foreber-v2/stm32-sinker-edm/docs/future-improvements.md

# G. Future Improvements

[⬅️ Back to Main](..)

---

## Coming Soon!
---

[⬅️ Back to Main](..)
