foreber-v2/stm32-sinker-edm/docs/engineering-decisions.md

# F. Engineering Decisions & Trade-offs 

[⬅️ Back to Main](..)

---

## Coming Soon!
---

[⬅️ Back to Main](..)
