foreber-v2/stm32-sinker-edm/docs/photos of electrode/IMG_20261029_143206.jpg

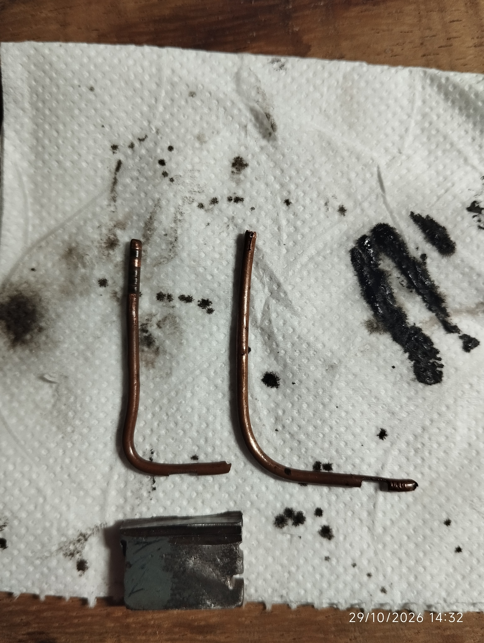
docs/photos of electrode/IMG_20261029_143206.jpg
