foreber-v2/stm32-sinker-edm/docs/photos of hardware/detail_rail_arm.jpg

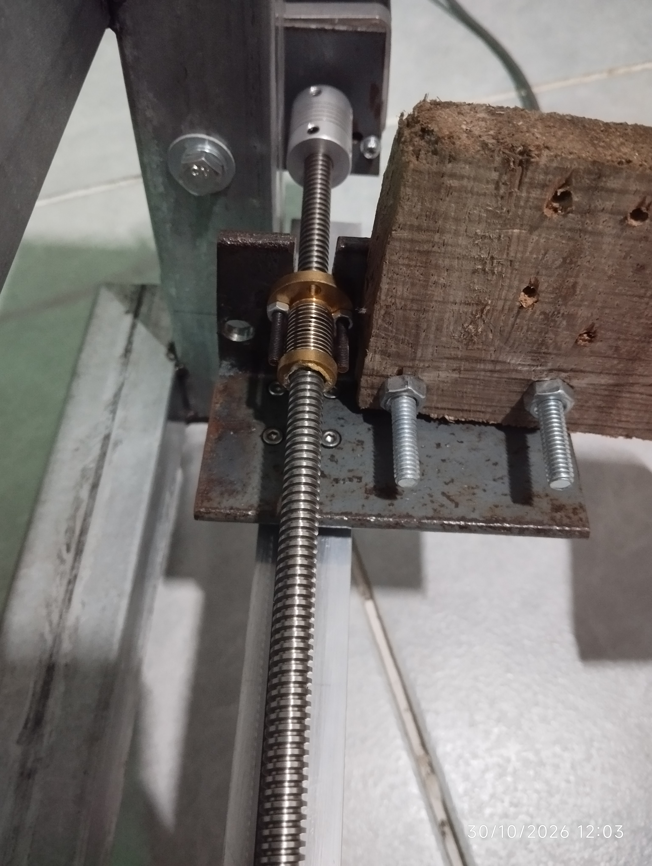
docs/photos of hardware/detail_rail_arm.jpg
