foreber-v2/stm32-sinker-edm/docs/photos of hardware/header_electrode.jpg

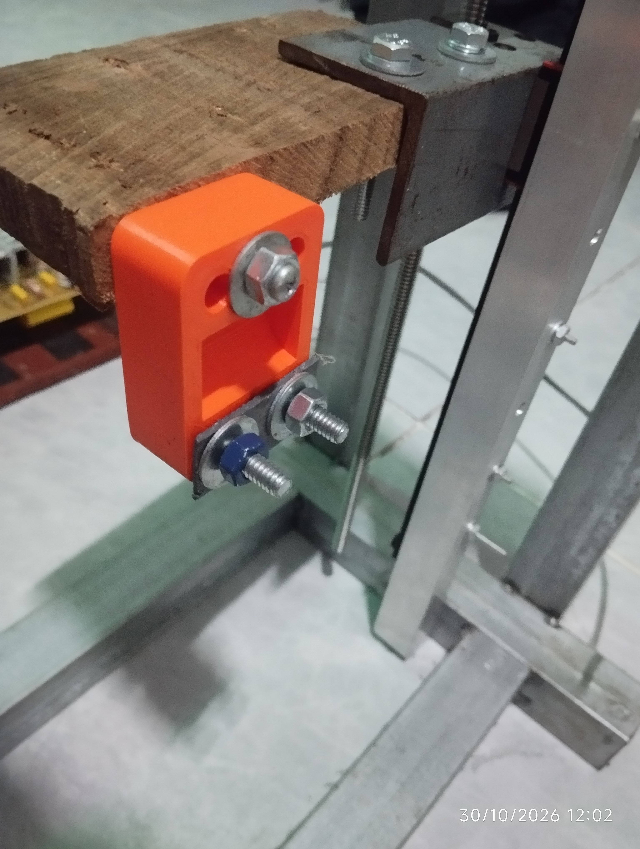
docs/photos of hardware/header_electrode.jpg
