foreber-v2/stm32-sinker-edm/docs/photos of hardware/IMG_20261030_114625.jpg

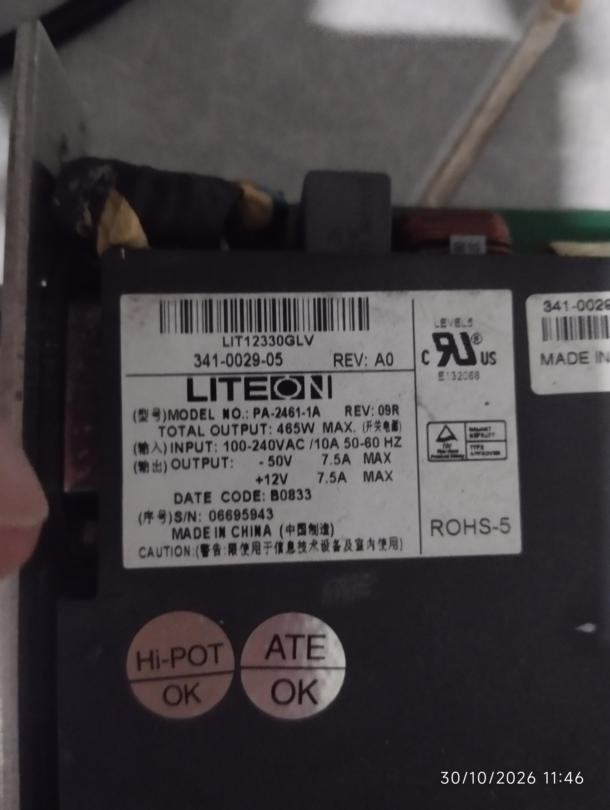
docs/photos of hardware/IMG_20261030_114625.jpg
