foreber-v2/stm32-sinker-edm/docs/photos of hardware/spark_gen.jpg

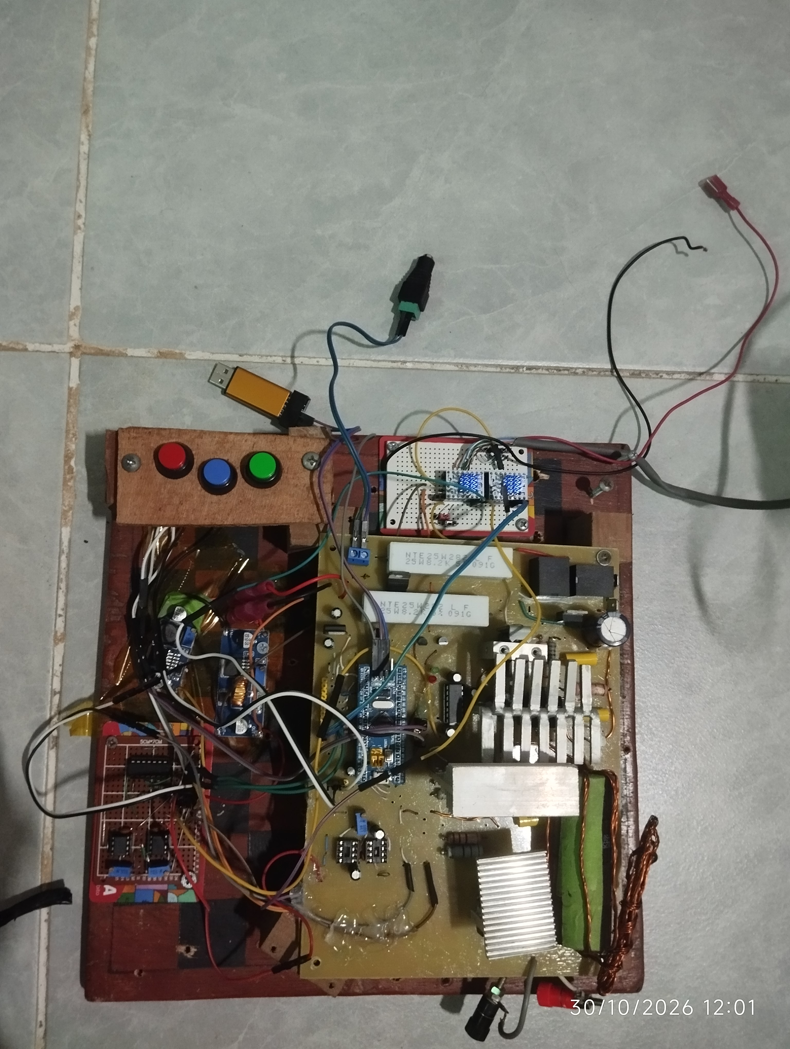
docs/photos of hardware/spark_gen.jpg
