foreber-v2/stm32-sinker-edm/docs/photos_of_electrode/electrodes_view_with_piece.jpg

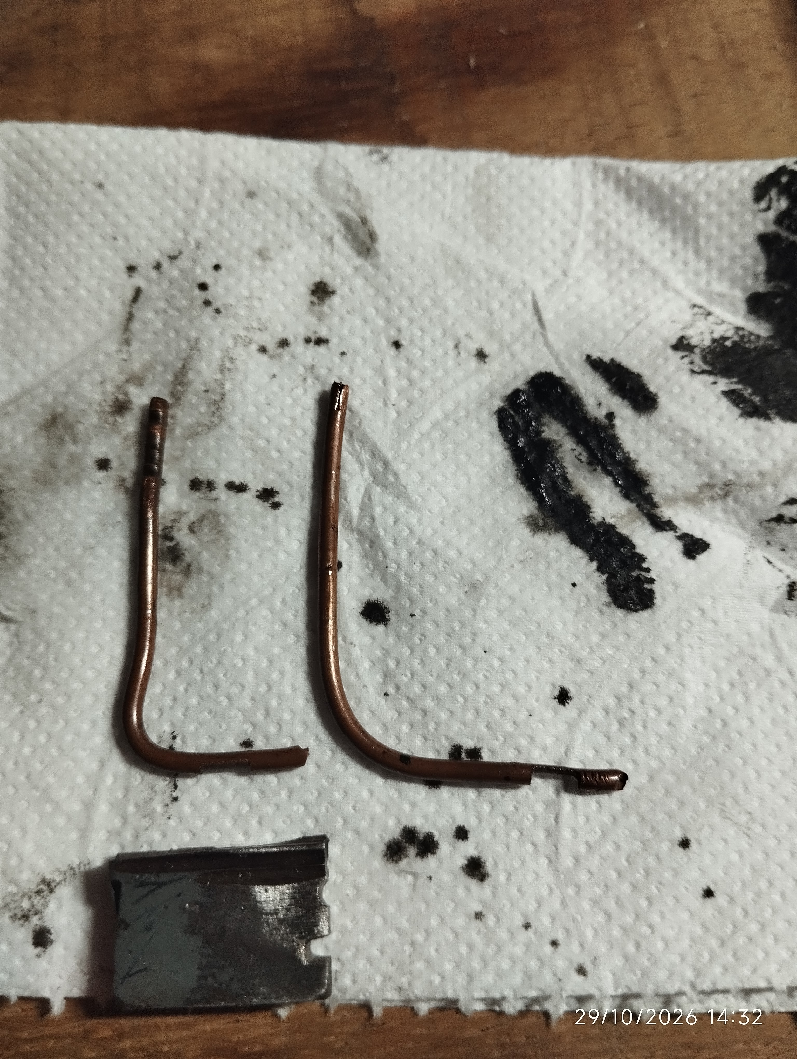
docs/photos_of_electrode/electrodes_view_with_piece.jpg
