foreber-v2/stm32-sinker-edm/images/photos_of_hardware/stepper_driver.jpg

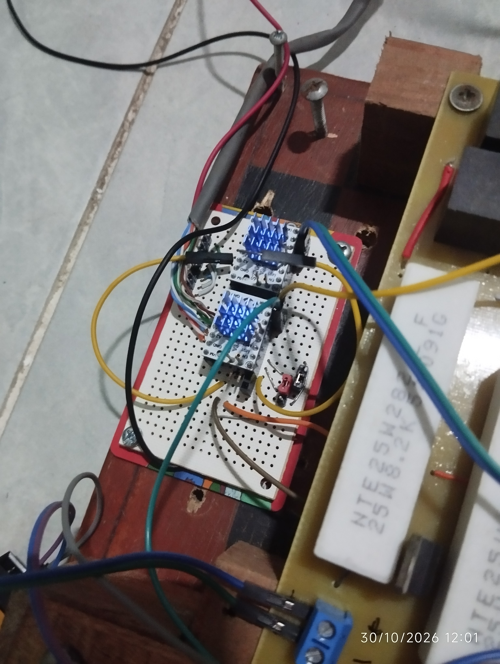
images/photos_of_hardware/stepper_driver.jpg
