foreber-v2/stm32-sinker-edm/photos of hardware/IMG_20261030_114457.jpg

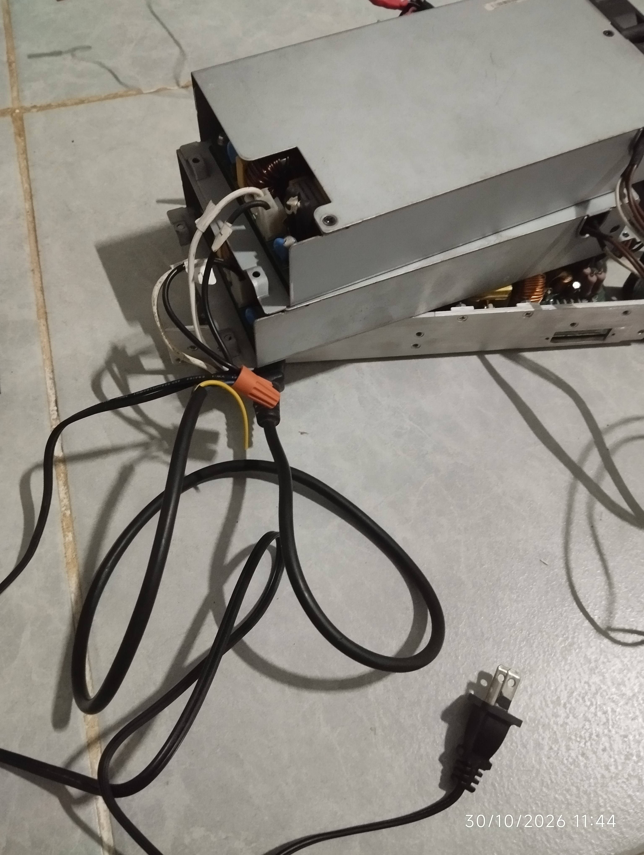
photos of hardware/IMG_20261030_114457.jpg
