foreber-v2/stm32-sinker-edm/photos of hardware/IMG_20261030_120720.jpg

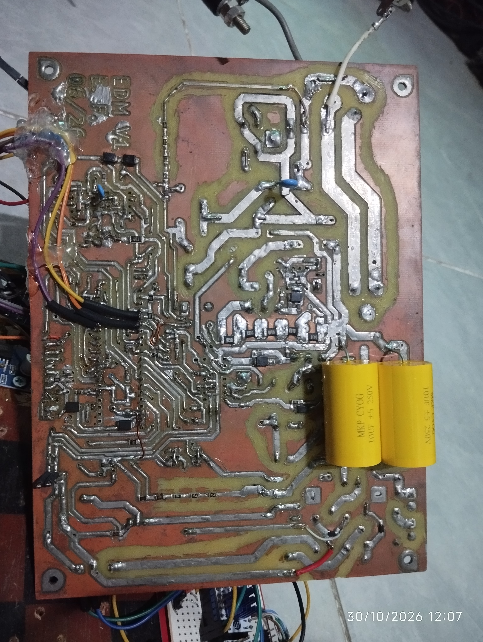
photos of hardware/IMG_20261030_120720.jpg
