foreber-v2/stm32-sinker-edm/edm_test_v4/edm_test_v4.csv

Reference | Qty | Value | Description
C1 | 1 | 4.7uF | Unpolarized capacitor
C2,C4 | 2 | 100uF | Polarized capacitor
C3,C5,C10,C13 | 4 | 10uF | Polarized capacitor,Unpolarized capacitor
C6,C7,C11 | 3 | 1nF x7r | Unpolarized capacitor
C8,C9 | 2 | 1u | Unpolarized capacitor
C12,C14,C15 | 3 | 100nF x7r | Unpolarized capacitor
C16,C19,C20,C22,C24,C25 | 6 | 100n | Unpolarized capacitor
C17,C18 | 2 | 4.7n | Unpolarized capacitor
C21,C23 | 2 | 4.7u | Polarized capacitor
D1,D2,D3,D4,D5,D6,D11,D12,D14 | 9 | SS14 | 40V 1A Schottky Diode, SMA
D7,D9,D10 | 3 | F8L60USM
D8 | 1 | SMAJ58A | 400W unidirectional Transient Voltage Suppressor, 58.0Vr, SMA(DO-214AC)
D13 | 1 | verde ready ind | Light emitting diode
D15 | 1 | rojo caps ind | Light emitting diode
DS1 | 1 | HY1602E lcd | LCD 16x2 Alphanumeric 16pin Blue/Yellow/Green Backlight, 8bit parallel, 5V VDD
J1 | 1 | Conn_01x02 | Generic connector, single row, 01x02, script generated (kicad-library-utils/schlib/autogen/connector/)
J2,J6 | 2 | Conn_01x20 | Generic connector, single row, 01x20, script generated (kicad-library-utils/schlib/autogen/connector/)
J3 | 1 | Screw_Terminal_01x02 | Generic screw terminal, single row, 01x02, script generated (kicad-library-utils/schlib/autogen/connector/)
J4 | 1 | Conn_01x05 | Generic connector, single row, 01x05, script generated (kicad-library-utils/schlib/autogen/connector/)
J5 | 1 | VSMPSIn | Generic connector, single row, 01x01, script generated (kicad-library-utils/schlib/autogen/connector/)
J7 | 1 | estado | Generic connector, single row, 01x02, script generated (kicad-library-utils/schlib/autogen/connector/)
J11 | 1 | GND | Generic connector, single row, 01x01, script generated (kicad-library-utils/schlib/autogen/connector/)
K4,K5 | 2 | JQC-3FF-005-1Z | Subminiature High Power SPDT Relay, 5V Coil nom. 0.36W, 10A switching current, max 10A@277VAC/28VDC
L1,L2 | 2 | 20uH
Q1,Q2,Q4 | 3 | S8050 | 0.7A Ic, 20V Vce, Low Voltage High Current NPN Transistor, TO-92
Q3 | 1 | IRF840A | N-Channel MOSFET, 8A Id, 500V Vds, 850mΩ Rds, TO-220
R1,R2,R6,R7,R10,R16,R46 | 7 | 10 | Resistor
R3,R4,R17,R23,R24,R41,R51,R52 | 8 | 10k | Resistor
R5,R55,R56,R57,R58,R59,R60 | 7 | 100 | Resistor
R8,R13,R18,R42 | 4 | 100k | Resistor
R9,R19,R22,R28,R30,R40,R54 | 7 | 1k | Resistor
R11,R20 | 2 | 8.2k 25w | Resistor
R12 | 1 | 8.2k | Resistor
R14,R15 | 2 | 3.3k | Resistor
R21 | 1 | 10K | Resistor
R25,R26 | 2 | 2.2 | Resistor
R27,R45 | 2 | 22k | Resistor
R29,R31,R32,R36,R37,R39 | 6 | 330k | Resistor
R33,R34,R35 | 3 | 150K | Resistor
R38 | 1 | R_Shunt | Shunt resistor with Kelvin connections
R43,R44,R49,R50 | 4 | 4.7k | Resistor
R47,R48,R53 | 3 | 220 | Resistor
RV1 | 1 | R_Potentiometer_Trim | Trim-potentiometer
RV2,RV3 | 2 | univuelta silicon | Trim-potentiometer
RV4 | 1 | R_Potentiometer | Potentiometer
TP1 | 1 | Vfet | test point
TP2 | 1 | Vgap | test point
TP3 | 1 | Vrdiode | test point
TP4 | 1 | TrigRele | test point
TP5 | 1 | TrigDriver | test point
TP6 | 1 | TringMosfet | test point
TP7 | 1 | out+DCDCbuck | test point
TP8 | 1 | out-DCDCbuck | test point
TP9 | 1 | in+DCDCbuck | test point
TP10 | 1 | in-DCDCbuck | test point
TP11 | 1 | shuntHsRoCT | test point
TP12,TP13 | 2 | shuntGnd | test point
TP14 | 1 | shuntHsCT | test point
TP15 | 1 | shuntHsR | test point
U1 | 1 | TC4420CPA
U2,U3 | 2 | LM311 | Voltage Comparator, DIP-8/SOIC-8
U4,U5 | 2 | STW20NM60
U6 | 1 | LM7805_TO220 | Positive 1A 35V Linear Regulator, Fixed Output 5V, TO-220
