foreber-v2/stm32-sinker-edm/docs/photos_of_hardware/all_parts.jpg

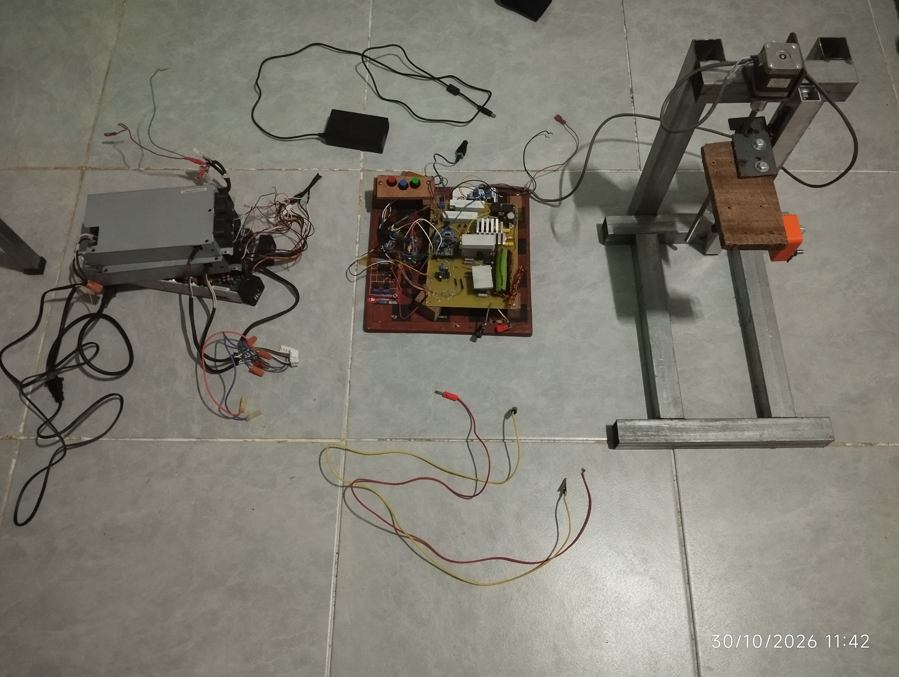
docs/photos_of_hardware/all_parts.jpg
