foreber-v2/stm32-sinker-edm/spark_gen_kicad/my_lib_folder/FGH40N60SFDTU/FGH40N60SFDTU.step

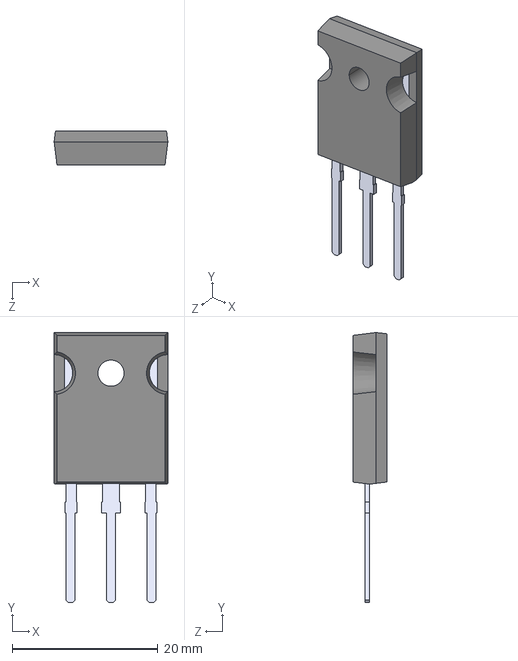
[picture p25: CAD file, 2026-11-04]
spark_gen_kicad/my_lib_folder/FGH40N60SFDTU/FGH40N60SFDTU.step
15.6 x 37.1 x 4.70 mm
