foreber-v2/stm32-sinker-edm/docs/experimental-results.md

# E. Experimental Results & Oscilloscope Captures

[⬅️ Back to Main](..)

---

## Coming Soon!
---

[⬅️ Back to Main](..)
