foreber-v2/stm32-sinker-edm/docs/photos of tests/magnetic_attraction.jpg

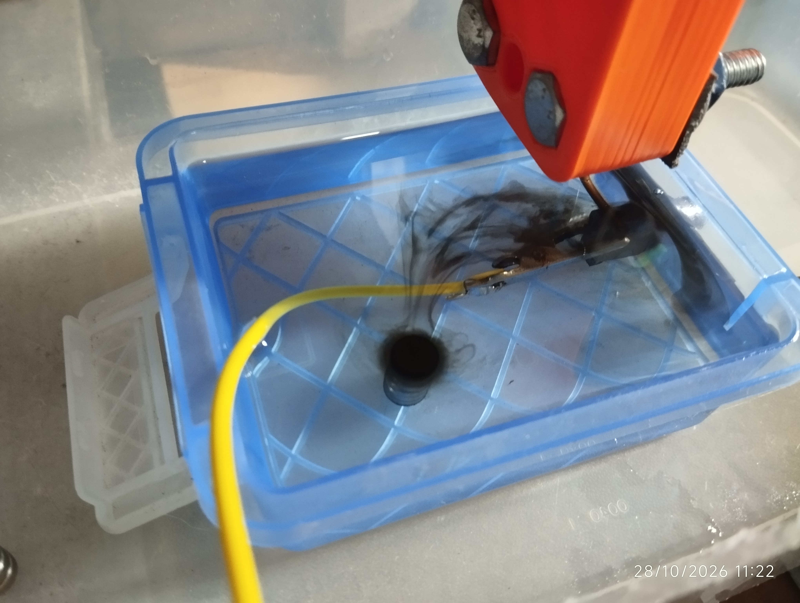
docs/photos of tests/magnetic_attraction.jpg
