foreber-v2/stm32-sinker-edm/docs/photos of tests/pol_inv_start.jpg

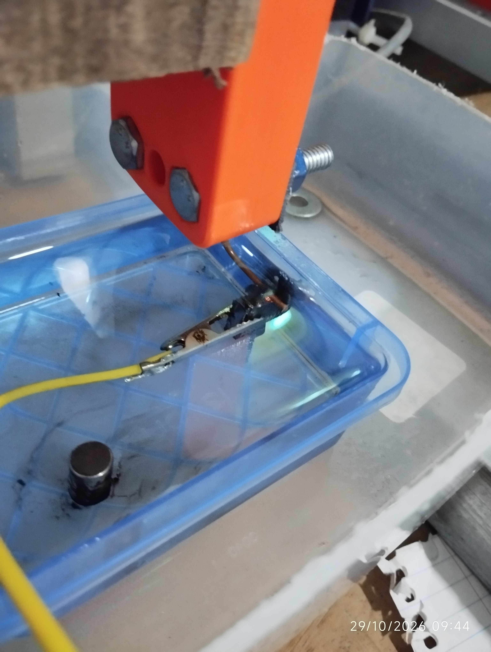
docs/photos of tests/pol_inv_start.jpg
