foreber-v2/stm32-sinker-edm/docs/photos_of_tests/pol_inv_end.jpg

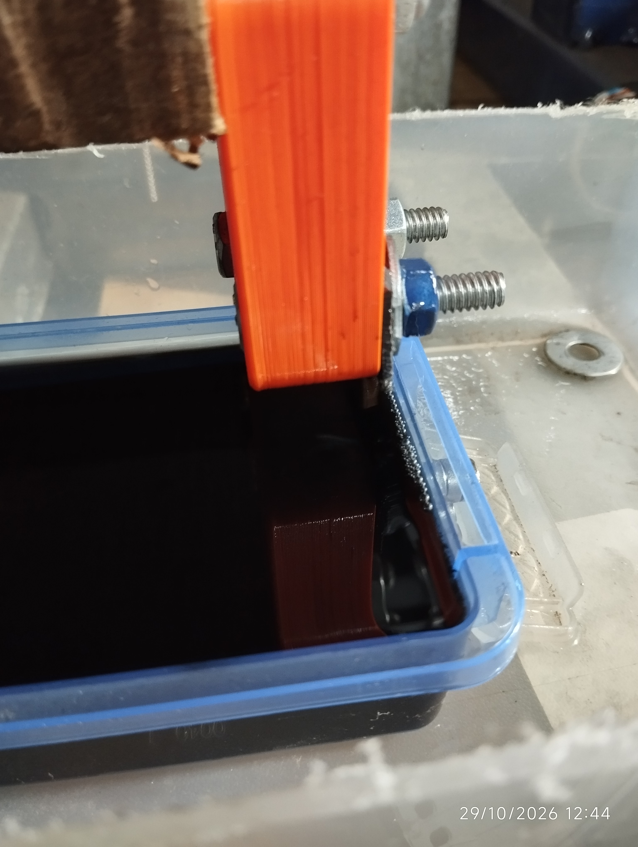
docs/photos_of_tests/pol_inv_end.jpg
