foreber-v2/stm32-sinker-edm/docs/photos_with_measurement/electrode_down.jpg

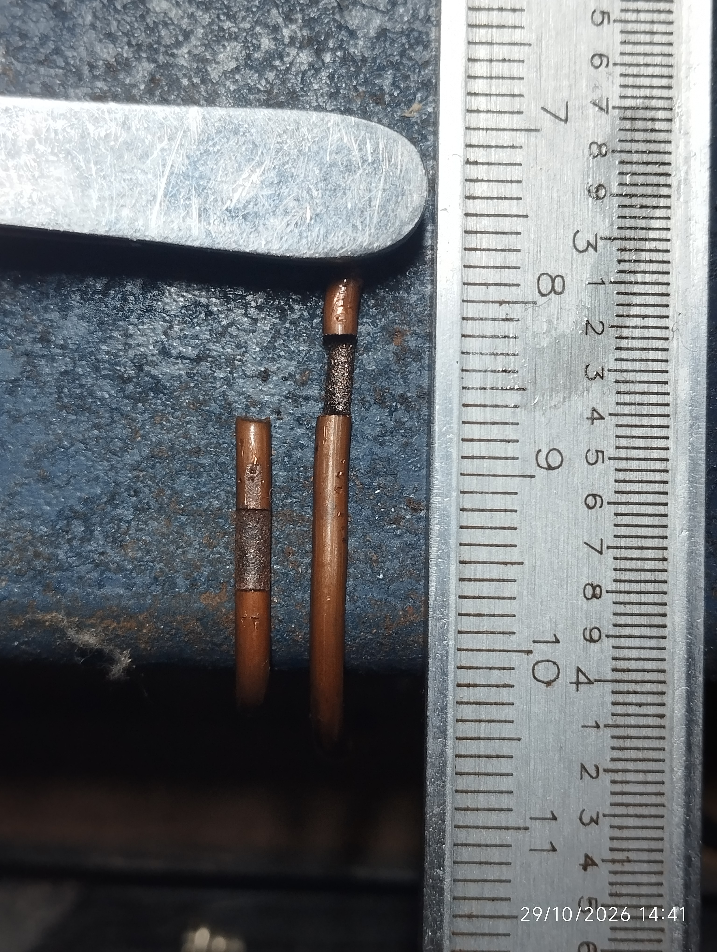
docs/photos_with_measurement/electrode_down.jpg
