foreber-v2/stm32-sinker-edm/docs/photos_with_measurement/piece_front.jpg

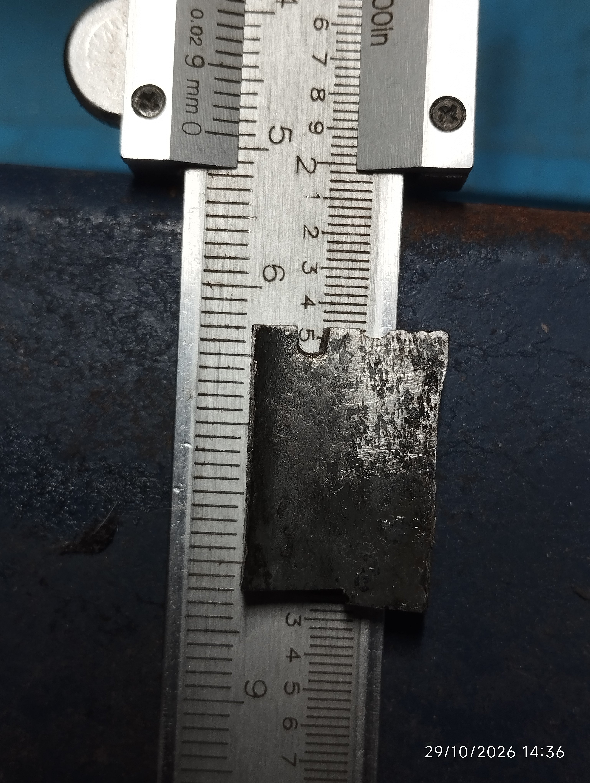
docs/photos_with_measurement/piece_front.jpg
