foreber-v2/stm32-sinker-edm/docs/photos_with_measurement/piece_up_2.jpg

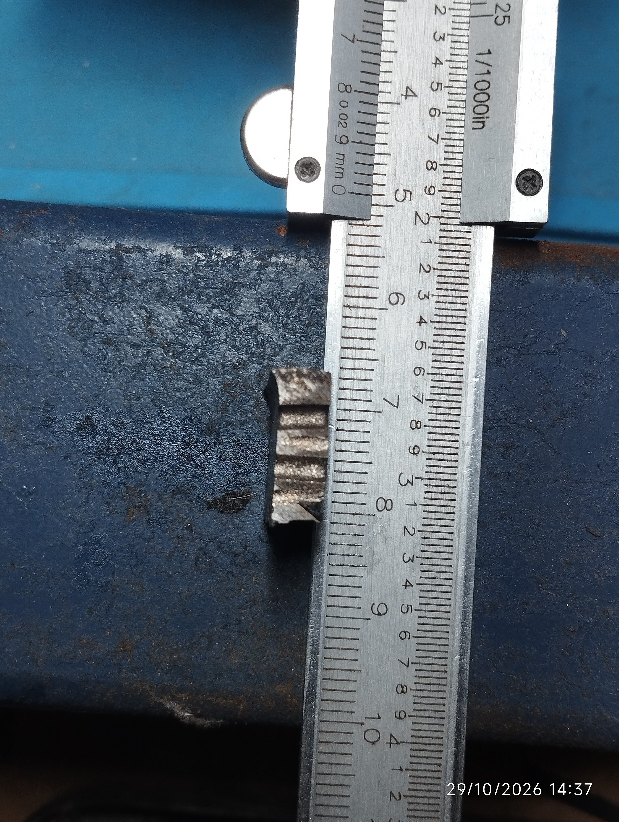
docs/photos_with_measurement/piece_up_2.jpg
