foreber-v2/stm32-sinker-edm/images/photos_of_tests/pol_dir_mid.jpg

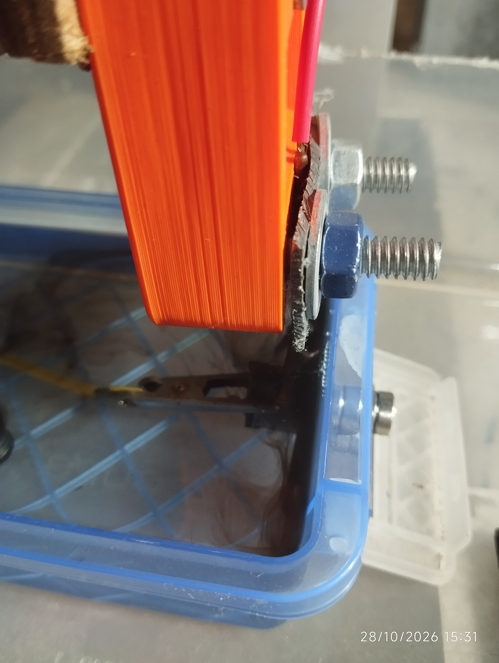
images/photos_of_tests/pol_dir_mid.jpg
