foreber-v2/stm32-sinker-edm/photos of tests/pol_dir_end.jpg

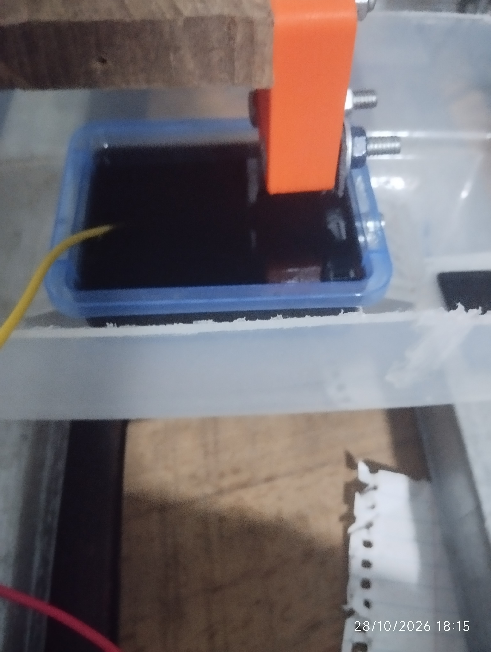
photos of tests/pol_dir_end.jpg
