foreber-v2/stm32-sinker-edm/photos of tests/pol_dir_start.jpg

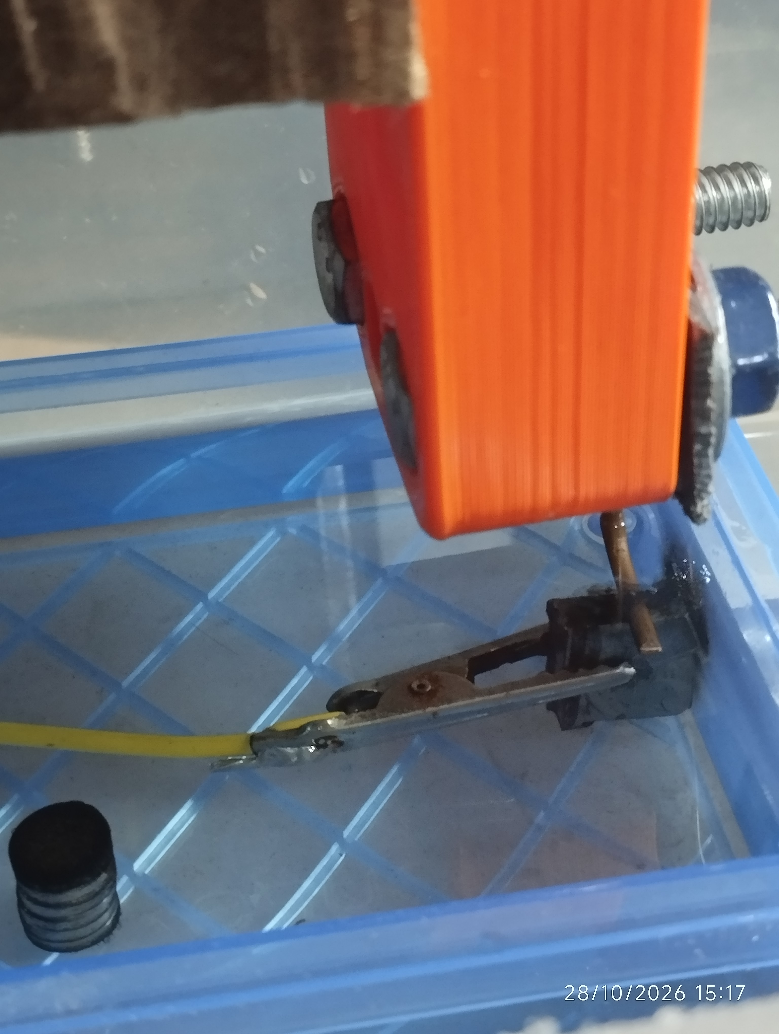
photos of tests/pol_dir_start.jpg
