foreber-v2/stm32-sinker-edm/photos of tests/pol_inv_mid.jpg

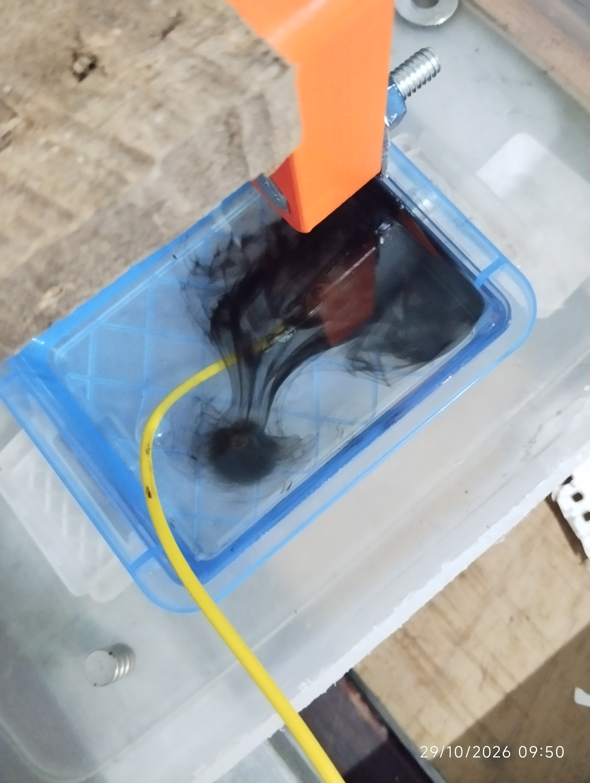
photos of tests/pol_inv_mid.jpg
