foreber-v2/stm32-sinker-edm/photos with measurement/IMG_20261029_143555.jpg

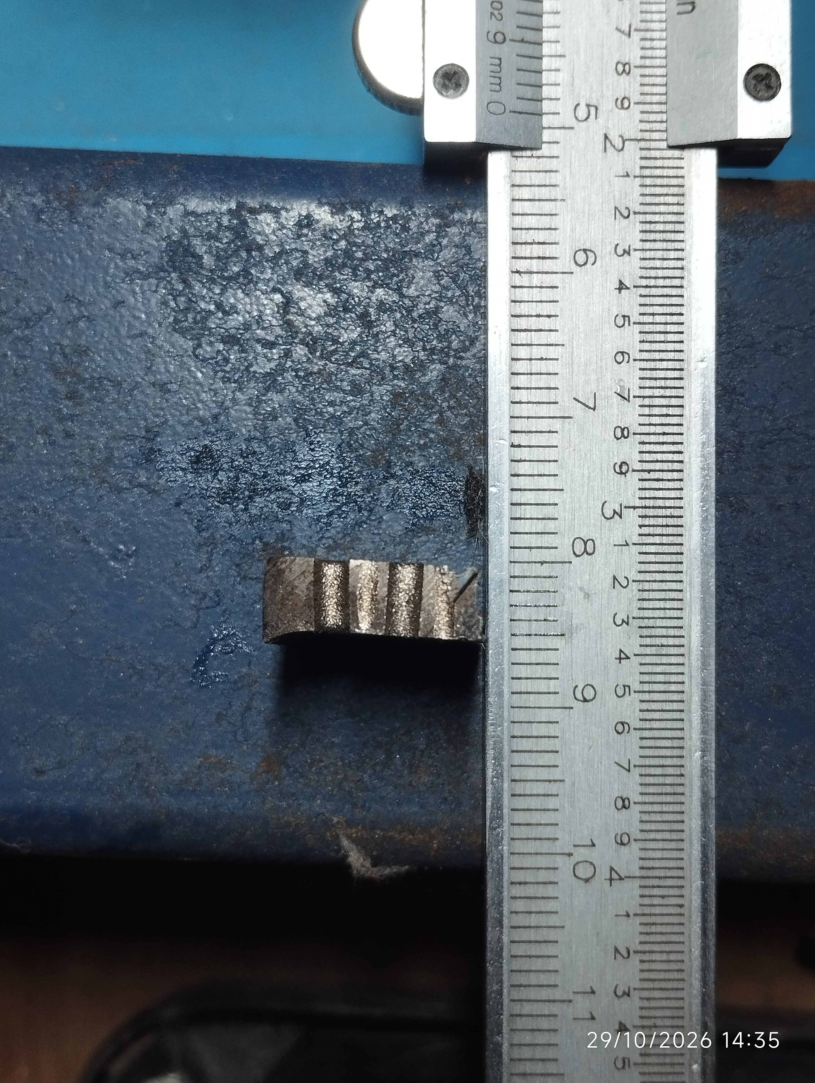
photos with measurement/IMG_20261029_143555.jpg
