foreber-v2/stm32-sinker-edm/spark_gen_kicad/edm_test_v4.kicad_pcb

## KiCad design spark_gen_kicad/edm_test_v4.kicad_pcb (2026-11-05)

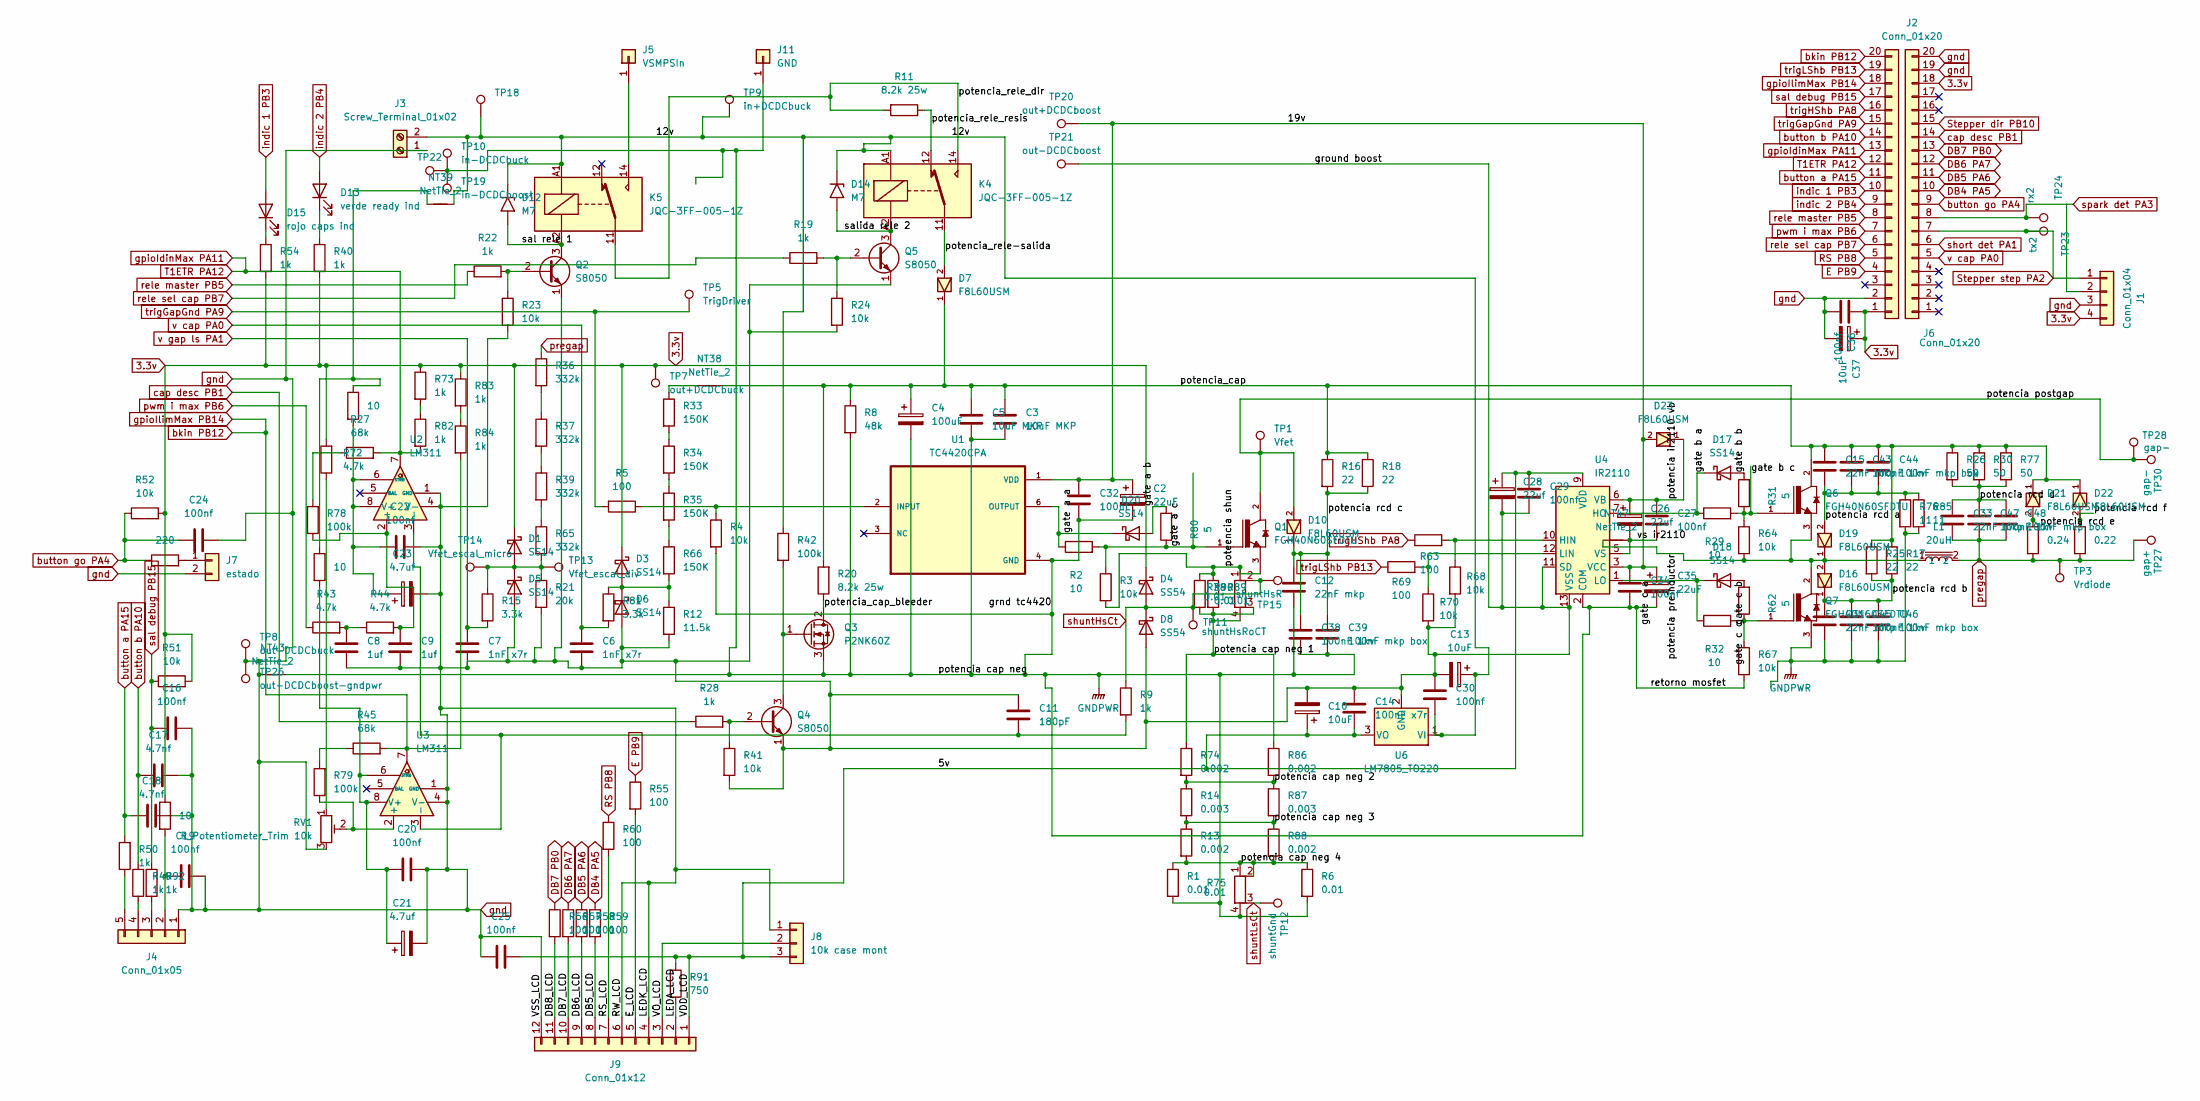
[picture p40: schematic edm_test_v4.kicad_sch]

Parts:
C2, C35: 22uF; CP_Radial_D5.0mm_P2.00mm
C3, C5: 10uF MKP; CP_Axial_L38.0mm_D21.0mm_P44.00mm_Horizontal
C4: 100uF; CP_Radial_D14.0mm_P7.50mm
C6, C7: 1nF x7r; C_Disc_D10.5mm_W5.0mm_P7.50mm
C8, C9: 1uf; C_1206_3216Metric_Pad1.33x1.80mm_HandSolder
C10, C13: 10uF; CP_Radial_D5.0mm_P2.50mm
C11: 180pF; C_Disc_D3.4mm_W2.1mm_P2.50mm
C12, C15, C31, C33: 22nF mkp; CP_Axial_L11.0mm_D6.0mm_P18.00mm_Horizontal
C14: 100nF x7r; C_0603_1608Metric_Pad1.08x0.95mm_HandSolder
C16, C19, C20, C22, C24, C25, C27, C29, C30, C32, C34, C36: 100nf; C_0603_1608Metric_Pad1.08x0.95mm_HandSolder
C17, C18: 4.7nf; C_0603_1608Metric_Pad1.08x0.95mm_HandSolder
C21, C23: 4.7uf; CP_Radial_D5.0mm_P2.50mm
C26, C28: 22uf; CP_Radial_D5.0mm_P2.50mm
C37: 10uF; CP_Radial_D5.0mm_P2.00mm
C38, C43, C45, C47: 100nF 1kv; C_Disc_D16.0mm_W5.0mm_P10.00mm
C39, C44, C46, C48: 100nF mkp box; C_Rect_L13.0mm_W6.0mm_P10.00mm_FKS3_FKP3_MKS4
D1, D3, D5, D6, D17, D18, D20: SS14; D_SMA
D4, D8: SS54; D_SMA
D7: F8L60USM; f8l60_c_disipador_incluido_techo
D10, D16, D19, D22, D23: F8L60USM; SOD113
D12, D14: M7; D_SMA
D13: verde ready ind; LED_D3.0mm_IRGrey
D15: rojo caps ind; LED_D3.0mm
D21: F8L60USM; f8l60_c_disipador_incluido
J1: Conn_01x04; PinSocket_1x04_P2.54mm_Vertical
J2, J6: Conn_01x20; PinSocket_1x20_P2.54mm_Vertical
J3: Screw_Terminal_01x02; TerminalBlock_MaiXu_MX126-5.0-02P_1x02_P5.00mm
J4: Conn_01x05; PinSocket_1x05_P2.54mm_Vertical
J5: VSMPSIn; TestPoint_2Pads_Pitch5.08mm_Drill1.3mm
J7: estado; PinSocket_1x02_P2.54mm_Vertical
J8: 10k case mont; PinSocket_1x03_P2.54mm_Vertical
J9: Conn_01x12; PinSocket_1x12_P2.54mm_Vertical
J11: GND; TestPoint_2Pads_Pitch5.08mm_Drill1.3mm
K4, K5: JQC-3FF-005-1Z; Relay_SPDT_Hongfa_JQC-3FF_0XX-1Z
L1: 20uH; L_Vertical_L75mm_D35mm_P85mm-uHcs270125e18X4
NT38, NT43, NT47: NetTie_2; NetTie-2_SMD_Pad2.0mm
NT39: NetTie_2
Q1: FGH40N60SFDTU; fgh40n60_c_disipador; PARTREV 2
Q2, Q4, Q5: S8050; TO-92_Inline
Q3: P2NK60Z; TO-220-3_Vertical
Q6: FGH40N60SFDTU; TO556P1587X482X2475-3; PARTREV 2
Q7: FGH40N60SFDTU; fgh40n60_c_disipador_y_diodo; PARTREV 2
R1, R6, R89, R90: 0.01; R_2512_6332Metric_Pad1.40x3.35mm_HandSolder
R2, R7, R10, R29, R32, R46: 10; R_1206_3216Metric_Pad1.30x1.75mm_HandSolder
R3, R51, R52, R64, R67: 10k; R_1206_3216Metric_Pad1.30x1.75mm_HandSolder
R4, R23, R24, R41, R68, R70: 10k; R_0805_2012Metric_Pad1.20x1.40mm_HandSolder
R5, R55: 100; R_1206_3216Metric_Pad1.30x1.75mm_HandSolder
R8: 48k; R_Axial_DIN0617_L17.0mm_D6.0mm_P5.08mm_Vertical
R9, R19, R22, R28, R40, R54, R73, R82, R83, R84: 1k; R_0805_2012Metric_Pad1.20x1.40mm_HandSolder
R11, R20: 8.2k 25w; R_Axial_Power_L60.0mm_W14.0mm_P66.04mm
R12: 11.5k; R_1206_3216Metric_Pad1.30x1.75mm_HandSolder
R13, R74, R86, R88: 0.002; R_2512_6332Metric_Pad1.40x3.35mm_HandSolder
R14, R87: 0.003; R_2512_6332Metric_Pad1.40x3.35mm_HandSolder
R15, R81: 3.3k; R_0805_2012Metric_Pad1.20x1.40mm_HandSolder
R16, R18: 22; R_Axial_DIN0516_L15.5mm_D5.0mm_P20.32mm_Horizontal
R17, R25: 22; R_Axial_DIN0414_L11.9mm_D4.5mm_P15.24mm_Horizontal
R21: 20k; R_1206_3216Metric_Pad1.30x1.75mm_HandSolder
R26, R30: 50; R_Axial_DIN0516_L15.5mm_D5.0mm_P20.32mm_Horizontal
R27, R45: 68k; R_2010_5025Metric_Pad1.40x2.65mm_HandSolder
R31, R62, R80: 5; R_1206_3216Metric_Pad1.30x1.75mm_HandSolder
R33, R34, R35, R66: 150K; R_1206_3216Metric_Pad1.30x1.75mm_HandSolder
R36, R37, R39, R65: 332k; R_1206_3216Metric_Pad1.30x1.75mm_HandSolder
R38: 0.01; R_Shunt_Vishay_WSK2512_6332Metric_T2.21mm
R42, R78, R79: 100k; R_1206_3216Metric_Pad1.30x1.75mm_HandSolder
R43, R44, R72: 4.7k; R_0805_2012Metric_Pad1.20x1.40mm_HandSolder
R49, R50, R92: 1k; R_1206_3216Metric_Pad1.30x1.75mm_HandSolder
R53: 220; R_Axial_DIN0204_L3.6mm_D1.6mm_P5.08mm_Horizontal
R56: 100; R_Axial_DIN0204_L3.6mm_D1.6mm_P7.62mm_Horizontal
R57, R58, R59, R60: 100; R_Axial_DIN0207_L6.3mm_D2.5mm_P10.16mm_Horizontal
R61: 0.24; R_Axial_DIN0516_L15.5mm_D5.0mm_P20.32mm_Horizontal
R63, R69: 100; R_0805_2012Metric_Pad1.20x1.40mm_HandSolder
R71: 0.22; R_Axial_DIN0516_L15.5mm_D5.0mm_P20.32mm_Horizontal
R75: 0.01; R_Shunt_Vishay_WSK2512_6332Metric_T2.66mm
R76, R85: 11; R_Axial_DIN0617_L17.0mm_D6.0mm_P25.40mm_Horizontal
R77: 50; R_Axial_DIN0617_L17.0mm_D6.0mm_P25.40mm_Horizontal
R91: 750; R_0805_2012Metric_Pad1.20x1.40mm_HandSolder
RV1: R_Potentiometer_Trim 10k; Potentiometer_Bourns_3296W_Vertical
TP1: Vfet; TestPoint_Keystone_5005-5009_Compact
TP3: Vrdiode; TestPoint_Keystone_5005-5009_Compact
TP5: TrigDriver; TestPoint_Keystone_5005-5009_Compact
TP7: out+DCDCbuck; TestPoint_Keystone_5005-5009_Compact
TP8: out-DCDCbuck; TestPoint_Keystone_5005-5009_Compact
TP9: in+DCDCbuck; TestPoint_Keystone_5005-5009_Compact
TP10: in-DCDCbuck; TestPoint_Keystone_5005-5009_Compact
TP11: shuntHsRoCT; TestPoint_Keystone_5005-5009_Compact
TP12: shuntGnd; TestPoint_Keystone_5000-5004_Miniature
TP13: Vfet_escal_div; TestPoint_Keystone_5005-5009_Compact
TP14: Vfet_escal_micro; TestPoint_Keystone_5000-5004_Miniature
TP15: shuntHsR; TestPoint_Keystone_5005-5009_Compact
TP18: in+DCDCboost; TestPoint_Keystone_5005-5009_Compact
TP19: in-DCDCboost; TestPoint_Keystone_5005-5009_Compact
TP20: out+DCDCboost; TestPoint_Keystone_5005-5009_Compact
TP21: out-DCDCboost; TestPoint_Keystone_5005-5009_Compact
TP22: guard; TestPoint_THTPad_1.5x1.5mm_Drill0.7mm
TP23: tx2; TestPoint_Keystone_5005-5009_Compact
TP24: rx2; TestPoint_Keystone_5005-5009_Compact
TP26: out-DCDCboost-gndpwr; TestPoint_Keystone_5005-5009_Compact
TP27: gap+; TestPoint_Keystone_5005-5009_Compact
TP28, TP30: gap-; TestPoint_Keystone_5005-5009_Compact
U1: TC4420CPA; DIP787W46P254L927H533Q8
U2, U3: LM311; DIP794W45P254L959H508Q8
U4: IR2110; DIP-14_W7.62mm
U6: LM7805_TO220; TO-220-3_Vertical

Connections:
3.3v: C36.1, C37.1, D1.1 (K), D3.1 (K), D4.1 (K), J1.4, J2.18, J6.1, R7.1, R40.2, R51.2, R52.2, R54.2, R72.2, R73.1, R83.1, TP7.1 (1_1)
/5v: C10.1, C14.1, C25.1, C28.1, C29.1, J8.3, J9.1, R91.1, U4.9 (VDD), U6.3 (VO)
/12v: C13.1, C30.2, D12.1 (A1), D14.1 (A1), J3.2, K4.A1, K5.A1, NT39.2, R42.1, TP9.1 (1_1), TP18.1 (1_1), U6.1 (VI)
/DB5_LCD: J9.8, R59.2
/DB6_LCD: J9.9, R58.2
/DB7_LCD: J9.10, R57.2
/DB8_LCD: J9.11, R56.2
/E_LCD: J9.5, R55.2
/LEDA_LCD: J9.2, R91.2
/RS_LCD: J9.7, R60.2
/VO_LCD: J8.2, J9.3
/gate a a: D20.1 (K), R2.1, U1.6 (OUTPUT), U1.7 (OUTPUT)
/gate a b: D20.2 (A), R80.2
/gate a c: Q1.1, R2.2, R3.1, R80.1
/gate b a: D17.1 (K), R29.1, U4.7 (HO)
/gate b b: D17.2 (A), R31.2
/gate b c: Q6.1, R29.2, R31.1, R64.1
/gate c a: D18.1 (K), R32.1, U4.1 (LO)
/gate c b: D18.2 (A), R62.2
/gate c c: Q7.1, R32.2, R62.1, R67.1
/poteencia shun: Q1.3, R3.2, R38.1, R89.1, R90.1
/potencia cap neg 1: R38.3, R38.4, R74.1, R86.1, R89.2, R90.2
/potencia cap neg 2: R14.1, R74.2, R86.2, R87.1
/potencia cap neg 3: R13.1, R14.2, R87.2, R88.1
/potencia cap neg 4: R1.1, R6.1, R13.2, R75.1, R75.2, R88.2
/potencia ir2110 vb: C26.1, C27.1, D23.1, U4.6 (VB)
/potencia postgap: D10.2, Q1.2, TP1.1 (1_1), TP28.1 (1_1), TP30.1 (1_1)
/potencia preinductor: D16.2, D19.1, L1.1, NT47.2, Q6.3, Q7.2, R64.2
/potencia rcd a: C15.1, C43.1, C44.1, D19.2, R76.1, R85.1
/potencia rcd b: C31.2, C45.2, C46.2, D16.1, R17.2, R25.2
/potencia rcd c: C12.2, C38.2, C39.2, D10.1, R16.2, R18.2
/potencia rcd d: C33.2, C47.2, C48.2, R26.2, R30.2, R77.2
/potencia rcd e: D21.2, R61.1
/potencia rcd f: D22.2, R71.1
/potencia_cap: C3.1, C4.1, C5.1, C15.2, C43.2, C44.2, D7.1, D21.1, D22.1, NT38.1, Q6.2, R8.1, R16.1, R17.1, R18.1, R20.2, R25.1, R26.1, R30.1, R77.1
/potencia_cap_bleeder: Q3.2 (D), R20.1
/potencia_rele-salida: D7.2, K4.11
/potencia_rele_dir: K4.14, K5.11, R11.2
/potencia_rele_resis: K4.12, R11.1
/sal rele 1: D12.2 (A2), K5.A2, Q2.3 (C)
/salida rele 2: D14.2 (A2), K4.A2, Q5.3 (C)
/vs ir2110: C26.2, C27.2, NT47.1, U4.5 (VS)
DB4 PA5: J2.10, R59.1
DB5 PA6: J2.11, R58.1
DB6 PA7: J2.12, R57.1
DB7 PB0: J2.13, R56.1
E PB9: J6.4, R55.1
GNDPWR: C2.2, C3.2, C4.2, C5.2, C12.1, C31.1, C32.2, C34.2, C35.2, C38.1, C39.1, C45.1, C46.1, J11.1 (Pin_1_1), NT43.1, Q3.3 (S), Q7.3, R1.2, R4.2, R6.2, R8.2, R67.2, R75.4, R76.2, R85.2, TP10.1 (1_1), TP19.1 (1_1), TP22.1 (1_1), U1.4 (GND), U1.5 (GND), U4.2 (COM)
unnamed: C8.2, R43.2, R44.1
unnamed: D1.2 (A), D5.1 (K), R15.1, R21.1, R65.2, TP13.1 (1_1), TP14.1 (1_1)
unnamed: D3.2 (A), D6.1 (K), R12.1, R66.2, R81.1
unnamed: D13.1 (K), R40.1
unnamed: D15.1 (K), R54.1
unnamed: C19.2, J4.2, R7.2
unnamed: J4.3, R92.2
unnamed: J4.4, R49.1
unnamed: J4.5, R50.1
unnamed: J5.1 (Pin_1_1), K5.14
unnamed: J7.1, R53.2
unnamed: NT38.2, R33.1
unnamed: NT39.1, R10.1, R46.1
unnamed: Q2.2 (B), R22.2, R23.1
unnamed: Q3.1 (G), Q4.3 (C), R42.2
unnamed: Q4.2 (B), R28.2, R41.1
unnamed: Q5.2 (B), R19.2, R24.1
unnamed: R27.1, R78.2
unnamed: R33.2, R34.1
unnamed: R34.2, R35.1
unnamed: R35.2, R66.1
unnamed: R36.2, R37.1
unnamed: R37.2, R39.1
unnamed: R39.2, R65.1
unnamed: R45.1, R79.2
unnamed: R72.1, RV1.1
unnamed: R73.2, R82.1
unnamed: R83.2, R84.1
unnamed: R4.1, R5.1, U1.2 (INPUT)
unnamed: C9.2, R44.2, R78.1, U2.2 (+)
unnamed: C11.1, R9.2, U2.3 (-), U3.3 (-)
unnamed: C22.2, C23.1, R10.2, U2.6 (STRB), U2.8 (V+)
unnamed: R79.1, RV1.2, U3.2 (+)
unnamed: C20.2, C21.1, R46.2, U3.6 (STRB), U3.8 (V+)
unnamed: R63.2, R68.1, U4.10 (HIN)
unnamed: R69.2, R70.1, U4.12 (LIN)
RS PB8: J6.5, R60.1
Stepper dir PB10: J2.15
Stepper step PA2: J1.1, J2.7, TP23.1 (1_1)
T1ETR PA12: J6.12, J6.13, R27.2, R82.2, U2.7
VDD: C2.1, C32.1, C34.1, C35.1, D23.2, TP20.1 (1_1), U1.1 (VDD), U1.8 (VDD), U4.3 (VCC)
bkin PB12: J6.18, J6.20, R45.2, R84.2, U3.7
button a PA15: C18.2, J6.11, R50.2
button b PA10: C17.2, J6.14, R49.2
button go PA4: C24.2, J2.9, R52.1, R53.1
cap desc PB1: J2.14, R28.1
gnd: C6.1, C7.1, C8.1, C9.1, C10.2, C11.2, C13.2, C14.2, C16.1, C17.1, C18.1, C19.1, C20.1, C21.2, C22.1, C23.2, C24.1, C25.2, C28.2, C29.2, C30.1, C36.2, C37.2, D5.2 (A), D6.2 (A), D8.2 (A), J1.3, J2.19, J2.20, J3.1, J4.1, J6.2, J7.2, J8.1, J9.4, J9.6, J9.12, NT43.2, Q2.1 (E), Q4.1 (E), Q5.1 (E), R12.2, R21.2, R23.2, R24.2, R41.2, R68.2, R70.2, RV1.3, TP8.1 (1_1), TP21.1 (1_1), TP26.1 (1_1), U2.1 (GND), U2.4 (V-), U3.1 (GND), U3.4 (V-), U4.11 (SD), U4.13 (VSS), U6.2 (GND)
indic 1 PB3: D15.2 (A), J6.10
indic 2 PB4: D13.2 (A), J6.9
pregap: C33.1, C47.1, C48.1, L1.2, R36.1, R61.2, R71.2, TP3.1 (1_1), TP27.1 (1_1)
pwm i max PB6: J6.7, R43.1
rele master PB5: J6.8, R22.1
rele sel cap PB7: J6.6, R19.1
sal debug PB15: C16.2, J6.17, R51.1, R92.1
short det PA1: J2.6
shuntHsCt: D4.2 (A), D8.1 (K), R9.1, R38.2, TP11.1 (1_1), TP15.1 (1_1)
shuntLsCt: R75.3, TP12.1 (1_1)
spark det PA3: J2.8, TP24.1 (1_1)
trigGapGnd PA9: J6.15, R5.2, TP5.1 (1_1)
trigHShb PA8: J6.16, R63.1
trigLShb PB13: J6.19, R69.1
v cap PA0: C6.2, J2.5, R81.2
v gap ls PA1: C7.2, R15.2

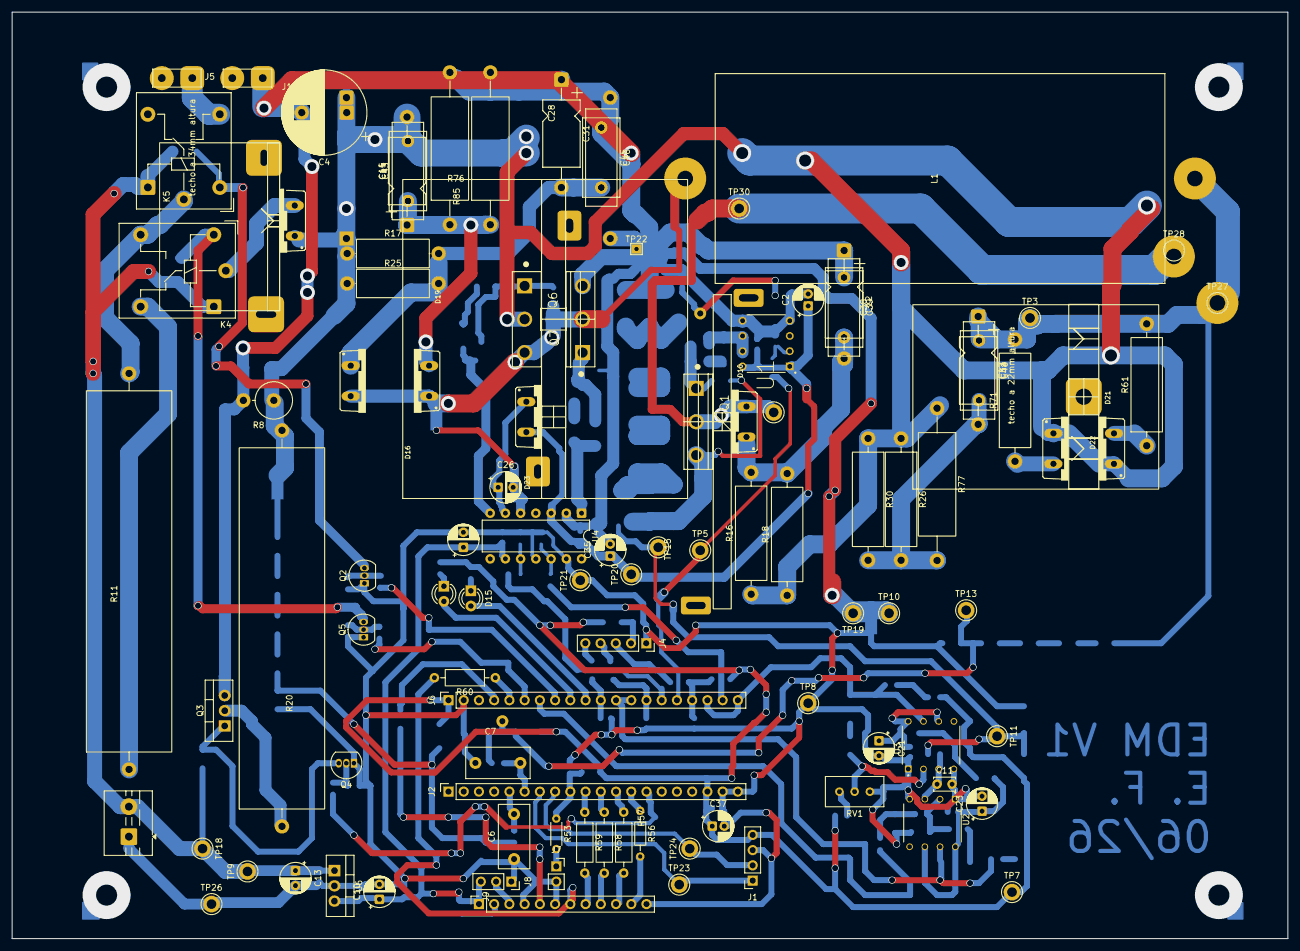
[picture p41: board edm_test_v4.kicad_pcb from above]

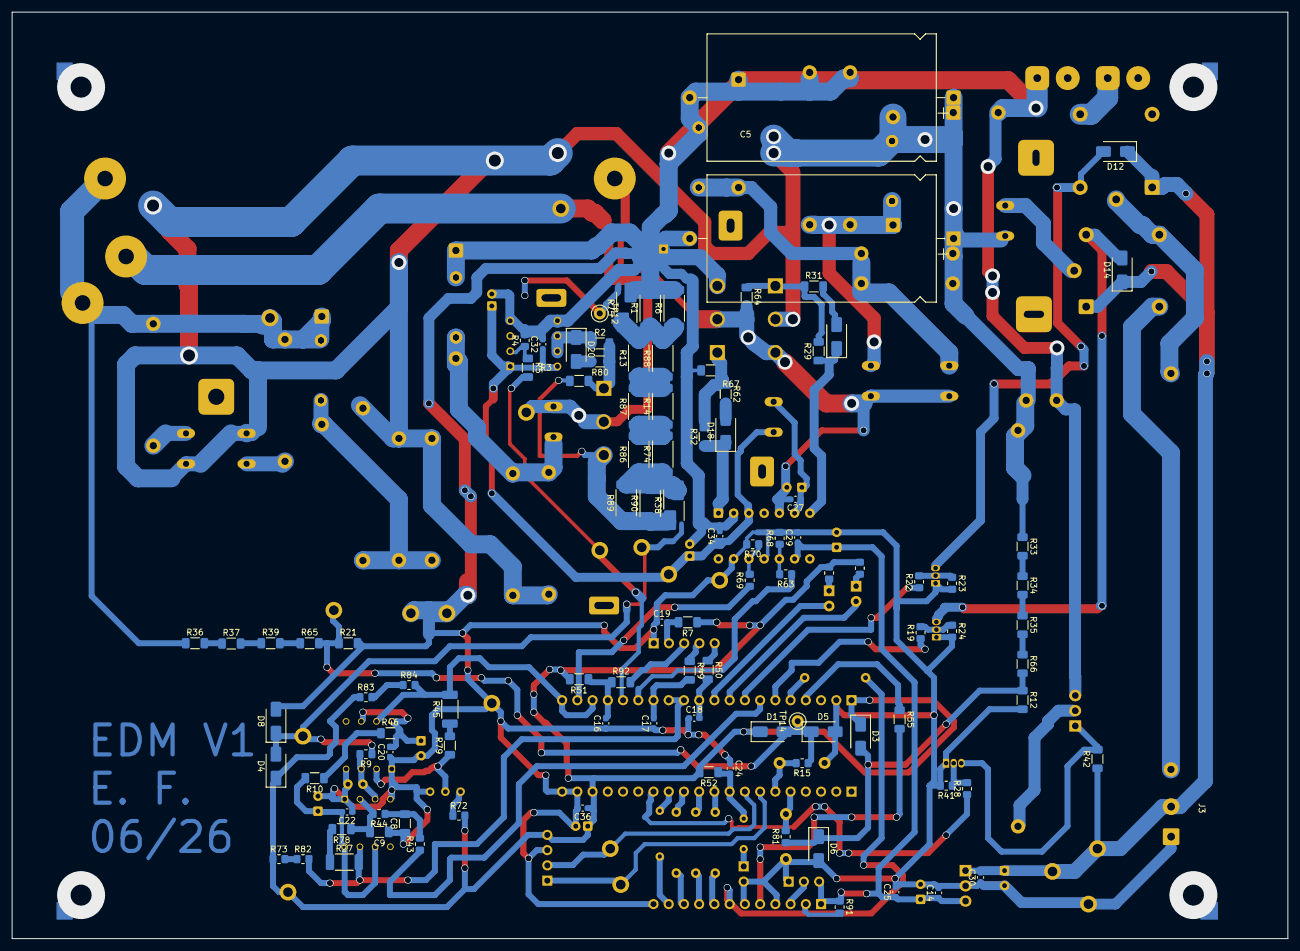
[picture p42: board edm_test_v4.kicad_pcb from below]

Board: 2 copper layers, 212.8 x 154.5 mm, 206 parts (105 on the bottom side), 109 nets.
