foreber-v2/stm32-sinker-edm/short_spark_detector_kicad/detector_cortos_v1.kicad_pcb

## KiCad design short_spark_detector_kicad/detector_cortos_v1.kicad_pcb (2026-11-04)

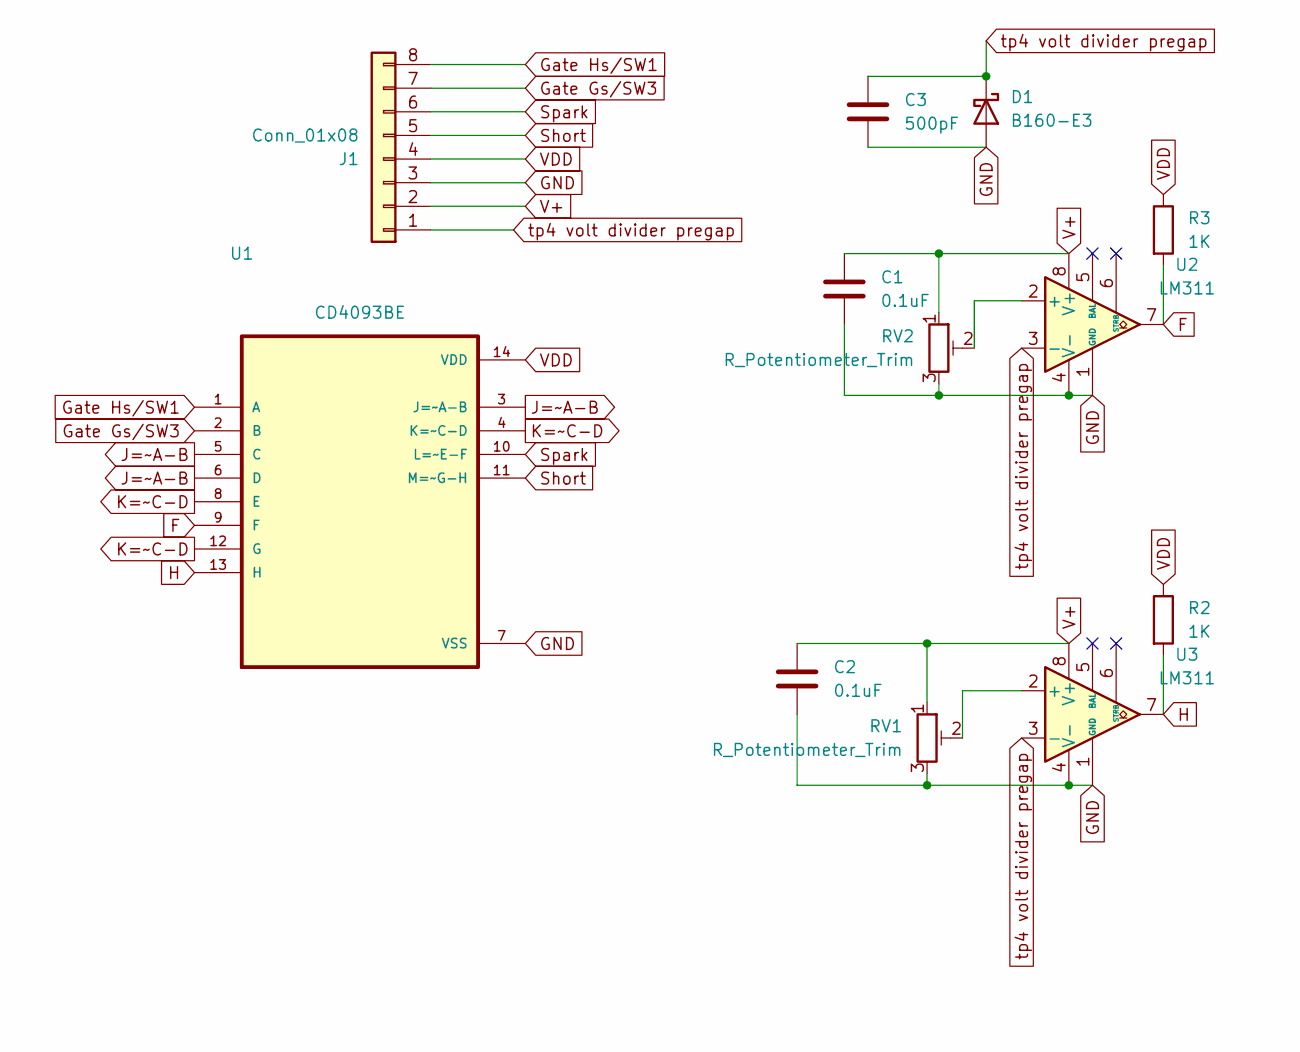
[picture p43: schematic detector_cortos_v1.kicad_sch]

Parts:
C1, C2: 0.1uF; C_Disc_D10.0mm_W2.5mm_P5.00mm
C3: 500pF; C_Disc_D10.0mm_W2.5mm_P5.00mm
D1: B160-E3; D_SMA
J1: Conn_01x08; PinHeader_1x08_P2.54mm_Vertical
R2, R3: 1K; R_Axial_DIN0207_L6.3mm_D2.5mm_P7.62mm_Horizontal
RV1, RV2: R_Potentiometer_Trim; Potentiometer_Vishay_T93YA_Vertical
U1: CD4093BE; DIP794W45P254L1969H508Q14; DigiKey_Part_Number 296-2068-5-ND
U2, U3: LM311; DIP794W45P254L959H508Q8

Connections:
F: R3.2, U1.9 (F), U2.7
GND: C1.2, C2.2, C3.2, D1.2 (A), J1.3, RV1.3, RV2.3, U1.7 (VSS), U2.1 (GND), U2.4 (V-), U3.1 (GND), U3.4 (V-)
Gate Gs/SW3: J1.7, U1.2 (B)
Gate Hs/SW1: J1.8, U1.1 (A)
H: R2.2, U1.13 (H), U3.7
J=~A-B: U1.3 (J=~A-B), U1.5 (C), U1.6 (D)
K=~C-D: U1.4 (K=~C-D), U1.8 (E), U1.12 (G)
unnamed: RV2.2, U2.2 (+)
unnamed: RV1.2, U3.2 (+)
Short: J1.5, U1.11 (M=~G-H)
Spark: J1.6, U1.10 (L=~E-F)
V+: C1.1, C2.1, J1.2, RV1.1, RV2.1, U2.8 (V+), U3.8 (V+)
VDD: J1.4, R2.1, R3.1, U1.14 (VDD)
tp4 volt divider pregap: C3.1, D1.1 (K), J1.1, U2.3 (-), U3.3 (-)

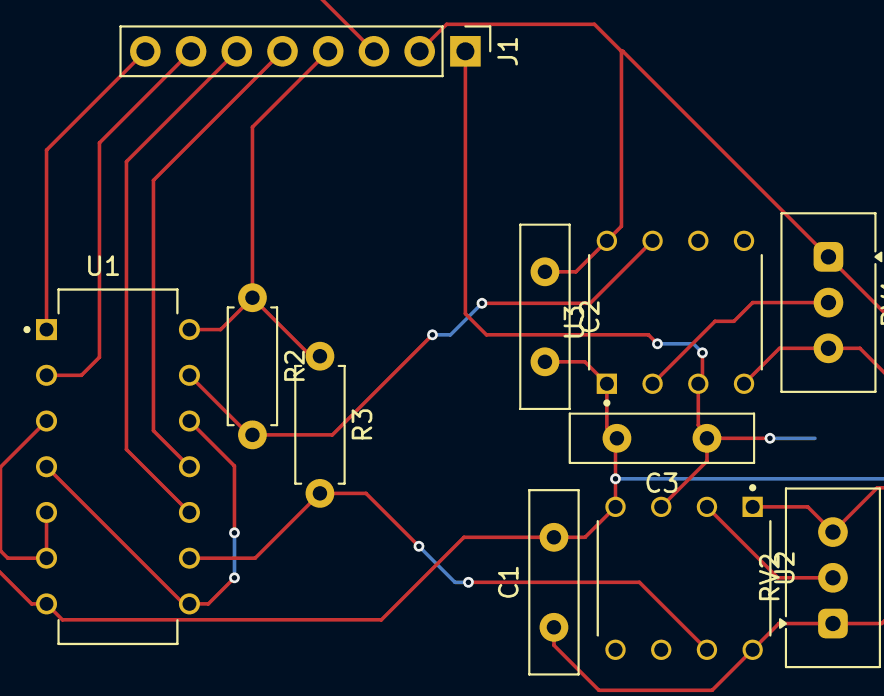
[picture p44: board detector_cortos_v1.kicad_pcb from above]

Board: 2 copper layers, 12 parts (1 on the bottom side), 14 nets.
