foreber-v2/stm32-sinker-edm/firmware_edm/MDK-ARM/Core/Inc/main.h

#define NVIC_PRIORITYGROUP_0         ((uint32_t)0x00000007) /*!< 0 bit  for pre-emption priority, 4 bits for subpriority */
#define NVIC_PRIORITYGROUP_1         ((uint32_t)0x00000006) /*!< 1 bit  for pre-emption priority, 3 bits for subpriority */
#define NVIC_PRIORITYGROUP_2         ((uint32_t)0x00000005) /*!< 2 bits for pre-emption priority, 2 bits for subpriority */
#define NVIC_PRIORITYGROUP_3         ((uint32_t)0x00000004) /*!< 3 bits for pre-emption priority, 1 bit  for subpriority */
#define NVIC_PRIORITYGROUP_4         ((uint32_t)0x00000003) /*!< 4 bits for pre-emption priority, 0 bit  for subpriority */
#define LED_GREEN_PIN           LL_GPIO_PIN_4
#define LED_GREEN_PORT          GPIOB
#define LED_RED_PIN             LL_GPIO_PIN_3
#define LED_RED_PORT            GPIOB
#define LED_SAFE_PIN            LL_GPIO_PIN_13
#define LED_SAFE_PORT           GPIOC
#define RELAY_MASTER_PIN        LL_GPIO_PIN_5
#define RELAY_MASTER_PORT       GPIOB
#define RELAY_CARGA_PIN         LL_GPIO_PIN_7
#define RELAY_CARGA_PORT        GPIOB
#define MOSFET_BLEEDER_PIN      LL_GPIO_PIN_1
#define MOSFET_BLEEDER_PORT     GPIOB
#define BTN_GO_PIN              LL_GPIO_PIN_4
#define BTN_GO_PORT             GPIOA
#define BTN_A_PIN               LL_GPIO_PIN_15
#define BTN_A_PORT              GPIOA
#define BTN_B_PIN               LL_GPIO_PIN_10
#define BTN_B_PORT              GPIOA
#define TIME_RELAY_WAIT_MS      8000    /* Capacitor charge time after relays ON    */
#define TIME_RELAY_DEL_WAIT_MS  100     /* Settling time after charge relay release */
#define TIME_LOCKOUT_MS         500     /* Lockout time after a manual stop         */
#define TIME_BLEEDING_WAIT_MS   8000    /* Total bleeding (discharge) time          */
#define TIME_BLINK_IDLE_MS      500     /* Green LED blink period in IDLE           */
#define TIME_BLINK_LOCKOUT_MS   200     /* Red / safe LED blink period              */
#define NUMBER_STEPS_DOWN_MAX   3500     /* Red / safe LED blink period              */
#define BAJA                    0       /* Move down (towards workpiece) */
#define SUBE                    1       /* Move up   (away from workpiece) */
#define TARGET_SPARKS           10000U  /* Only used by the commented-out debug counters in main.c */
