foreber-v2/stm32-sinker-edm/(commit log)

2026-11-04 Agrega estructura de carpetas docs
2026-11-04 Create .gitignore for temporary files and outputs
    Add .gitignore file for KiCad and Keil uVision projects
2026-11-04 Agrega proyectos limpios de KiCad y Keil
2026-11-05 Enhance README with project details and documentation
    Added project overview, current development status, and documentation index to README.
2026-11-05 Add system architecture documentation
    Added detailed system architecture documentation including high-level block diagram, power electronics topology, pre-charge and discharge networks, and user interface feedback.
2026-11-05 Revise system architecture documentation
    Updated system architecture documentation with detailed sections on high-level block diagram, power electronics topology, pre-charge and discharge networks, and user interface feedback.
2026-11-05 Revise system architecture documentation
    Updated system architecture documentation with detailed explanations of the power electronics topology, pre-charge and discharge networks, and user interface.
2026-11-05 Revise system architecture documentation
    Updated system architecture documentation with detailed descriptions of the high-level block diagram, power electronics topology, pre-charge and discharge networks, and user interface.
2026-11-05 Enhance hardware documentation with detailed sections
    Expanded the hardware documentation to include detailed sections on KiCad schematics, PCB modifications, and a key bill of materials.
2026-11-05 Revise hardware documentation and add images
    Updated hardware documentation with additional details on PCB modifications, component choices, and added images for clarity.
2026-11-05 Revise hardware documentation and BOM details
    Updated hardware documentation with detailed modifications and component choices.
2026-11-05 Revise hardware documentation and add images
    Updated hardware documentation with detailed modifications, images, and BOM.
2026-11-05 Revise hardware documentation and BOM details
    Updated hardware documentation with detailed sections on PCB modifications, galleries of hardware details, and a comprehensive Bill of Materials (BOM).
2026-11-05 Fix link status for Hardware & Bill of Materials section
2026-11-05 add bom interactive
2026-11-05 Enhance hardware documentation with interactive BOM
    Added interactive BOM section and updated hardware details.
2026-11-05 Revise hardware documentation and BOM details
    Updated hardware documentation with detailed sections on KiCad schematics, PCB modifications, and Bill of Materials.
2026-11-05 Revise hardware documentation and BOM details
    Updated hardware documentation with detailed modifications, component choices, and interactive BOM link.
2026-11-05 Revise hardware documentation and BOM details
    Updated hardware documentation with detailed modifications and BOM.
2026-11-10 Create main FSM documentation for Blue Pill STM32F103C8
    Added state diagram for the main FSM of the Blue Pill STM32F103C8.
2026-11-10 Add discharge driver FSM documentation
    Added state diagram for the discharge driver FSM in discharge.c, detailing states and transitions.
2026-11-10 update format firmware stepper
2026-11-10 Add FSM diagram for stepper driver TIM2 update
2026-11-10 Enhance firmware documentation for STM32 Sinker EDM
    Added detailed firmware documentation for the STM32 Sinker EDM controller, including project structure, state machines, and safety handling.
2026-11-10 Update print statement from 'Hello' to 'Goodbye'
