foreber-v2/stm32-sinker-edm/(notices)

Notices in the files:
firmware_edm/MDK-ARM/Core/Inc/main.h:
Copyright (c) 2026 STMicroelectronics.
All rights reserved.
This software is licensed under terms that can be found in the LICENSE file
